Crowdedlight/ColliView/assets/colliview.png

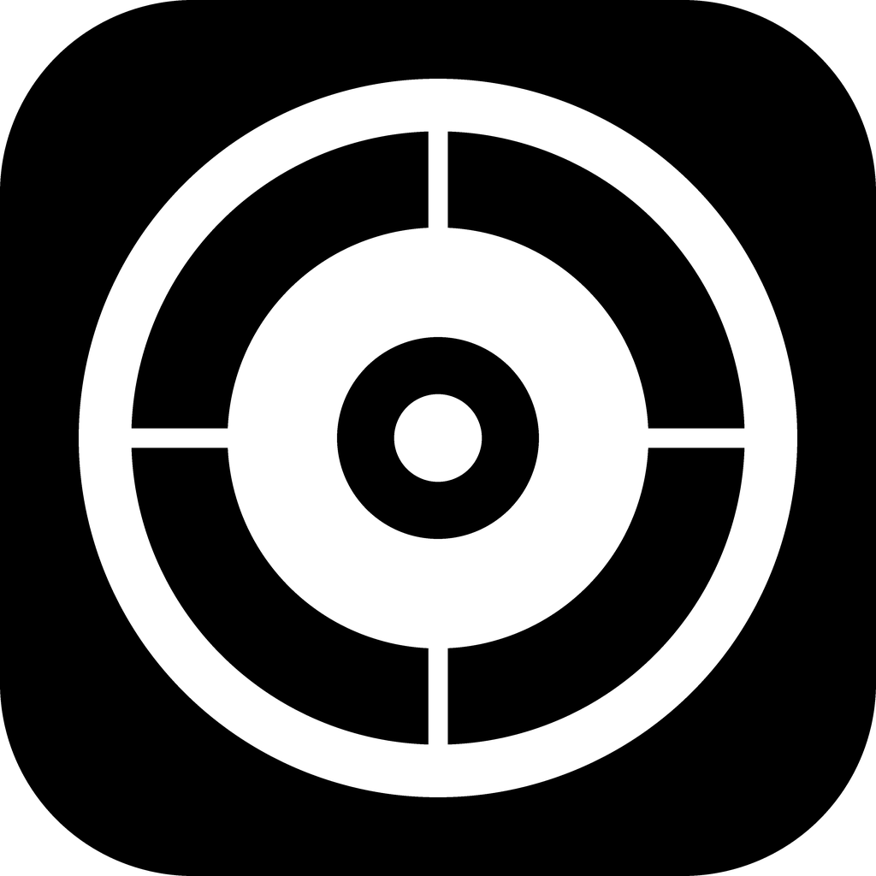
assets/colliview.png
