Crowdedlight/ColliView/(commit log)

2026-10-05 initial version
    [colliview_adapter.scad]
2026-10-08 added exploded view for assembly
    [colliview_adapter.scad]
2026-10-09 tolerance adding for 3D print
    [colliview_adapter.scad]
2026-10-15 updated readme and default preset based on the received board and measurements
    [colliview_adapter.scad]
2026-10-17 increased center square for pcb board for imx179 preset and wire passthrough hole so it fits. Also made the lid press-fit to avoid gluing it
    [colliview_adapter.scad]
2026-10-17 added routine for calibration of centering kamera with liveview to adjust offset in
2026-10-18 backup commit of work tree. Has multie changes and fixes back and forth with off-center calibration
    [colliview_adapter.scad]
2026-10-18 removed old calibration methods as they did not work in practice nor was super nessecary. Instead made a jig that can be 3D printed and used to center the camera in the 2-inch barrel, or just using a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
    [colliview_adapter.scad]
2026-10-19 added release workflow and cleaned up readme and hardware presets
    [colliview_adapter.scad]
2026-10-19 fixed endless dragging for the input fields and changed rotation from steps of 5 to steps of 1deg
    [app.rs]
2026-10-21 added icon and changed the software so it uses the centering jig to align the camera sensor center with the two holes so its centered in the tube
2026-10-21 added image of physical device to readme
